DeSciL/PettingZoo/schematics/circuit_adafruit_vs1053_breakout.drawio.jpg

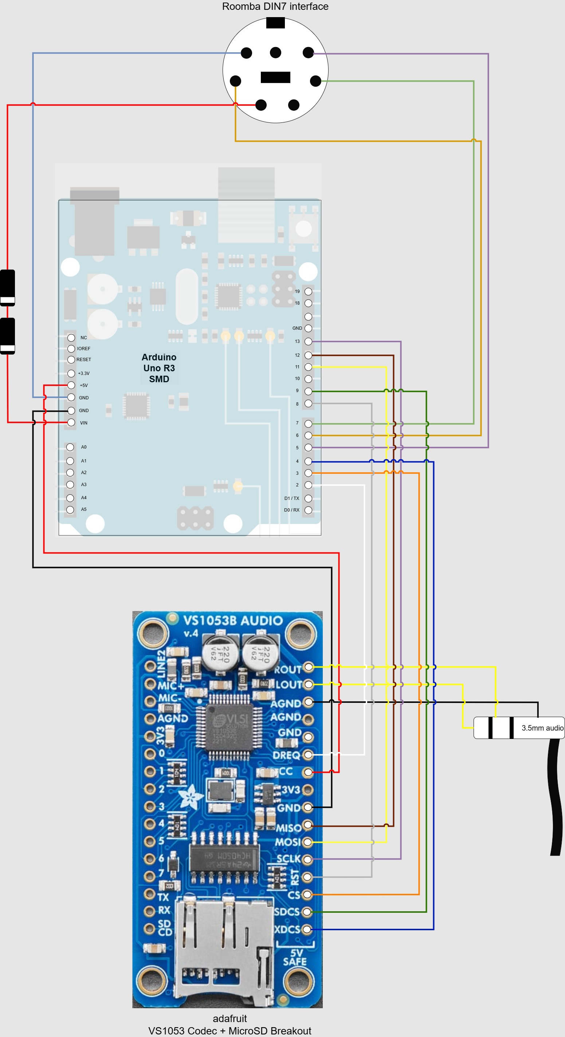
schematics/circuit_adafruit_vs1053_breakout.drawio.jpg
