DeSciL/PettingZoo/schematics/circuit.drawio.jpg

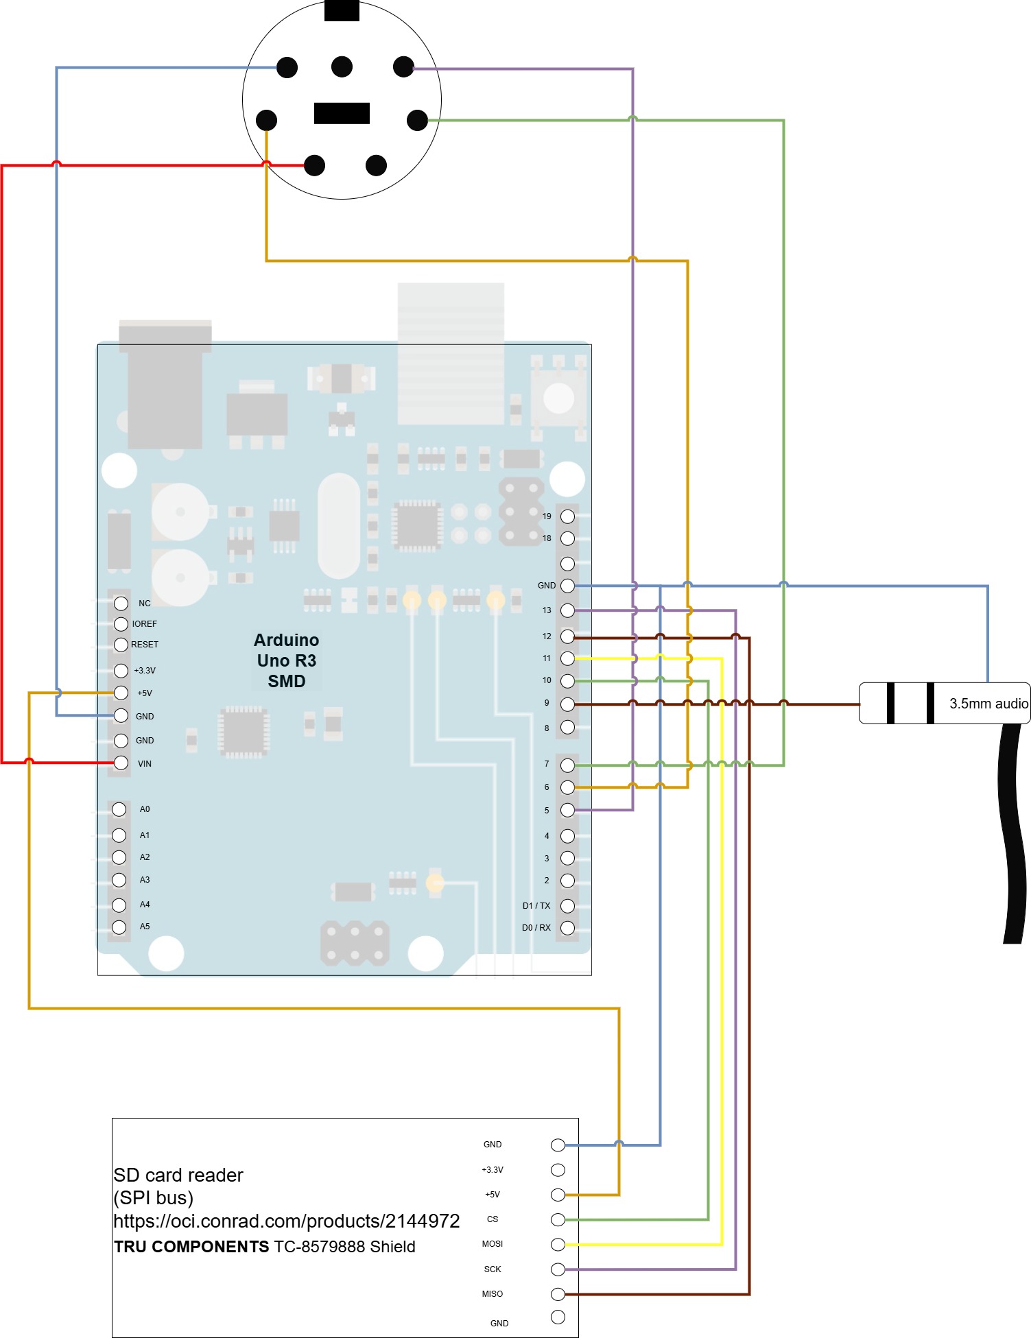
schematics/circuit.drawio.jpg
