DeSciL/PettingZoo/schematics/circuit_SparkFun.drawio.jpg

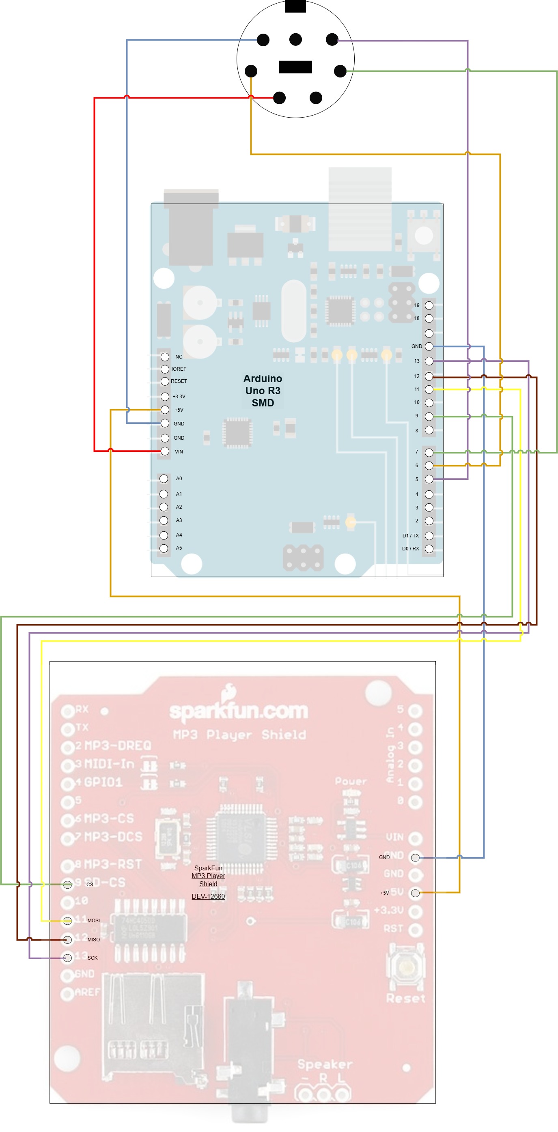
schematics/circuit_SparkFun.drawio.jpg
