DeSciL/PettingZoo/(threads)

Thread 10 (2025-05-20):

VacuumRobots: Evaluate Arduino R4 Wifi

mawidme, 2025-05-20:
this was dropped as the R4 is incompatible with most arduino libraries

Closed 2025-05-20.

Thread 11 (2025-05-20):

fix wire isolation

mawidme, 2025-05-20:
Right now, the wires connecting the roomba DIN7 interface to the Arduino UNO aren't either isolated at all or only makeshift with black tape.
- [ ] Isolate properly to avoid pins making contact, e.g. use heat-shrink tubing

Thread 2 (2025-05-20):

VacuumRobots: Start

mawidme, 2025-05-20:
Emily's proposal for a hands-on installation at the Bits 'n Bolts Robotival 2025 has been accepted - and it proposed to recreate the very popular and fun 'popularity contest at the robotic petting zoo' event Emily developed and staged with two collaborators (Merel Bekking and Ruud Hortensius) in 2017. What we'll need to do (before May!) is to buy the vacuuming robots, all the arduino/raspberry pi pieces (plus other bits and bobs), and essentially bring this installation back to life so it's ready for the festival in 2025.

the festival: https://bitsnbolts.ueberaktiv.ch/

github repository: https://github.com/chaudhuryB/PettingZoo

Proposal:
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

Result after searching Digitec:
- Vaccuming robots:
  - iRobot Roomba Combo Essential Y0: https://www.digitec.ch/en/s1/product/irobot-roomba-combo-essential-y0-y0112-vacuum-mopping-robot-robot-vacuum-cleaners-43134731
  - EDIT: better use original roomba 605, as the new version uses a newer developer framework
  - now sourcing roombas 600 series second hand from tutti.ch and ricardo.ch
- Arduino Uno Circuit boards
  - Arduino UNO R4 WiFi https://www.galaxus.ch/de/s1/product/arduino-uno-r4-wifi-entwicklungsboard-kit-36704956
  - Alternatively use original Arduino UNO R3 instead: https://www.digitec.ch/en/s1/product/arduino-uno-rev3-development-boards-kits-5764177)
- 8G microSDHC cards
  - IMRO 10/8G ADP Speicherkarte 8 GB MicroSDHC Klasse 10
  - https://www.galaxus.ch/de/s1/product/imro-108g-adp-speicherkarte-8-gb-microsdhc-klasse-10-microsdhc-8-gb-u1-uhs-i-speicherkarte-15684375
- Arduino Breadboards: Tru Components Board mit Mini-Steckplatine für Arduino UNO  https://www.galaxus.ch/de/s1/product/tru-components-board-mit-mini-steckplatine-fuer-arduino-uno-entwicklungsboard-kit-21601927
- Playpens
  - https://www.galaxus.ch/de/s15/product/gd-playpen-347x232cm-5300250-gehege-49566131
- Bugelperlen beads bucket
  - Creativ Company Bügelperlen Nabbi Medium
  - https://www.galaxus.ch/de/s5/product/creativ-company-buegelperlen-nabbi-medium-buegelperlen-8355643

Closed 2025-05-20.

Thread 3 (2025-05-20):

VacuumRobots: Evaluate Arduino sound board

mawidme, 2025-05-20:
- [x] ~Adafruit wave audio shield~
  - https://www.digitec.ch/de/s1/product/adafruit-wave-audio-shield-fuer-arduino-diverse-elektronikmodul-6061183
  - out of stock everywhere
- [ ] ~Sparkfun MP3 player shield~
  - dropped due to shortage in online stores
  - https://learn.sparkfun.com/tutorials/mp3-player-shield-hookup-guide-v15
- [x] Adafruit MP3 Music Maker shield
  - this is the board we finally selected
  - source: https://www.berrybase.ch/vs1053-codec-microsd-breakout-mp3-wav-midi-ogg-play-record

Closed 2025-05-20.

Thread 5 (2025-05-20):

VacuumRobots: HW tests

mawidme, 2025-05-20:
- [x] battery stamina
  - test, note, evaluate
- [x] speakers loud enough?
- [x] DIN7 interface with arduino
  - 1 failed, model 675
- [x] vacuum strong enough? test with "bügelperlen" (plastic beads)

Closed 2025-05-20.

Thread 6 (2025-05-20):

VacuumRobots: purchase list/history

mawidme, 2025-05-20:
- [x] decided on 18.3.2025 with emily: invest up to 10h for audio shields
  - PWM audio quality is too terrible

ORDER ACCESSORIES
- [ ] ~5x 1x 3.5mm audio plug~
  - ~https://www.digitec.ch/de/s1/product/delock-terminalblock-35mm-klinke-buchse-klinkenadapter-audio-adapter-7029065~
  - dropped as unnecessary with audio board
- [x] transparent plastic tubes to "count votes"
  - bought by Emily
- [x] fences
  - bought by Emily
  - suggestion to emily: https://www.galaxus.ch/en/s15/product/tectake-puppy-run-cages-enclosures-11209013
  - not available anymore: https://www.galaxus.ch/de/s15/product/gd-playpen-347x232cm-5300250-gehege-49566131
- [x] Bugelperlen beads bucket
  - bought by Emily
  - https://www.galaxus.ch/en/s5/product/ratings/folia-buegelperlen-buegelperlen-13853792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
    - probably too big (in diameter): https://www.galaxus.ch/de/s5/product/creativ-company-buegelperlen-nabbi-medium-buegelperlen-8355643
  - how many kg?
  - which size? probably small...

ORDER 5 (14.4.2025)
- [x] 1x more jumper cables
  - https://www.digitec.ch/de/s1/product/play-zone-jumperkabel-elektronikkabel-stecker-8030022?supplier=406802
- [x] 5x speakers
  - evaluate if loud enough for environment at the dynamo event
  - https://www.digitec.ch/de/s1/product/hama-tube-30-12-h-batteriebetrieb-bluetooth-lautsprecher-23952990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
- [x] 6x Adafruit VS1053 Codec + MicroSD Breakout
  - [x] https://www.berrybase.ch/vs1053-codec-microsd-breakout-mp3-wav-midi-ogg-play-record
  - conrad: 10stk, CHF 48, https://oci.conrad.com/products/1516575
  - play-zone.ch: >10stk, CHF 38, https://www.play-zone.ch/de/adafruit-vs1053-codec-microsd-breakout-mp3-wav-midi-ogg.html

ORDER 4 (9.4.2025)
- [x] ~1x Adafruit "Music Maker" MP3 Shield~
  - https://www.distrelec.ch/de/arduino-music-maker-shield-adafruit-1788/p/30139063?redirectQuery=301-39-063
  - order was canceled due to ETA > 3 months

ORDER 3 (10.3.2025)
- [x] 5x Arduino UNO Rev3
  - https://oci.conrad.com/products/191789
- [x] 6x Mini DIN 7 connector
  - https://www.conrad.ch/de/p/bkl-electronic-0204005-miniatur-din-rundsteckverbinder-stecker-gerade-polzahl-7-schwarz-1-st-731781.html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
    - alternative? https://www.digitec.ch/de/s1/product/rnd-high-end-mini-din-steckverbinder-100v-1a-7-pole-stecker-elektronikkabel-stecker-52638223

ORDER 2
- [x] 1x Arduino UNO R4 Wifi
  - https://www.digitec.ch/de/s1/product/arduino-uno-r4-wifi-entwicklungsboard-kit-36704956?supplier=406802
- [x] 1x bluetooth speaker with 3.5mm audio in
  - https://www.digitec.ch/de/s1/product/hama-tube-30-12-h-batteriebetrieb-bluetooth-lautsprecher-23952990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
- [x] 1x 3.5mm audio plug
  - https://www.digitec.ch/de/s1/product/delock-terminalblock-35mm-klinke-buchse-klinkenadapter-audio-adapter-7029065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
- [x] 1x SparkFun MP3 player shield
  - https://www.digitec.ch/de/s1/product/sparkfun-mp3-player-shield-shield-elektronikmodul-5998751?supplier=406802
  - https://learn.sparkfun.com/tutorials/mp3-player-shield-hookup-guide-v15
- [x] 6x microSD card, 4GB
  - https://www.digitec.ch/de/s1/product/intenso-micro-secure-digital-card-micro-sd-class-10-microsdhc-4-gb-u1-speicherkarte-9856410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
- [x] 6x audio cable 3.5mm, 30cm
  - https://www.digitec.ch/de/s1/product/startech-mu1mms2ra-030-m-35mm-klinke-aux-audio-kabel-10164793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
- [x] 1x jumper cables
  - 40 pieces: https://www.digitec.ch/de/s1/product/play-zone-jumperkabel-elektronikkabel-stecker-8030022?supplier=406802

ORDER 1 (25.11.2024, conrad.ch)
- [x] 1x 191789 ARDUINO UNO R3 SMD
- [x] 1x 2144972 TRU COMPONENTS SD-Karten Logging-Shield
- [x] 50x 162213 DIODE 1N4001 50V/1A DIO

Closed 2025-05-20.

Thread 8 (2025-05-20):

VacuumRobots: test mp3 shield with other arduino libraries

mawidme, 2025-05-20:
EDIT 25.4.2025: this task was dropped in favor of the new adafruit vs1053 breakout board

- [ ] https://github.com/pschatzmann/arduino-audio-tools
  - fix for strtof not found
    - Use "strtod" instead of "strtof"
    - macro #define strtof(A, B) strtod(A, B)
  - dependency arduino-vs1053: https://github.com/pschatzmann/arduino-vs1053
    - pinouts: https://github.com/pschatzmann/arduino-vs1053/wiki/Pinouts-for-Processors-and-Tested-Boards
  - blog post about VS1053 MP3 Shield in conjunction with Arduino UNO R4
    - https://web.archive.org/web/20241106071625/https://www.pschatzmann.ch/home/2023/07/15/arduino-uno-r4-vs1053-mp3-shield/
    - associated example: https://github.com/pschatzmann/arduino-audio-tools/blob/main/examples/examples-vs1053/player-sdfat-vs1053/player-sdfat-vs1053.ino
  - ~[ ] compile for arduino uno R3~
    - not possible due to insufficient memory -> fallback to only use the vs1053 driver
  - [x] fix vs1053 errors
    - VS1053 - VS1053 error retry SB:0000 R1:FFFF R2:FFFF
    - VS1053 - VS1053 error retry SB:012C R1:FFFF R2:FFFF
    - ...
    - those errors are gone after a fresh boot, i.e. power cycle

Closed 2025-05-20.

Thread 9 (2025-05-20):

VacuumRobots: Specify hardware

mawidme, 2025-05-20:
- Roomba vacuum cleaning robot
  - Potential irobots cleaner to buy: [iRobot Roomba Combo Essential Y0 (Y0112)](https://www.digitec.ch/en/s1/product/irobot-roomba-combo-essential-y0-y0112-vacuum-mopping-robot-robot-vacuum-cleaners-43134731l)
  - EDIT 21.11.2024: We decided to buy a used Roomba 605 for testing as this is expected to require less software changes. On the other hand, the hardware/mechanics may fail at some point.
    - https://www.tutti.ch/de/vi/aargau/haushalt/geraete-utensilien/irobot-roomba-605-staubsauger/70306289
  - EDIT 21.1.2025: We bought additional used Roomba models from the 600 series from ricardo.ch.
    - https://www.ricardo.ch/de/a/robot-roomba-605-staubsauger-aspirateur-1262013792/
    - https://www.ricardo.ch/de/a/i-robot-roomba-1278716556/
    - https://www.ricardo.ch/de/a/irobot-roomba-620-staubsauger-roboter-1279082902/
- cables
  - https://www.digitec.ch/de/s1/product/play-zone-jumperkabel-elektronikkabel-stecker-8030022
