DeSciL/PettingZoo/(commit log)

2025-02-03 added circuit diagram
2025-03-17 added circuit drawing for SparkFun MP3 shield
2025-03-17 default circuit drawing (PCM audio): added audio connector
2025-04-04 added personality sounds/configs: excited, fearful, happy, surprised
    [config.txt]
2025-04-25 added schematic for adafruit audio board (WIP) - adafruit vs1053 breakout
2025-04-25 adafruit breakout: completed schematic (TODO: wire colors)
2025-05-02 adafruit schematic: updated wire colors
2025-05-20 readme: added audio board notes
2025-05-20 schematics: exported .drawio as .jpg
2025-05-20 moved schematics to sub-folder
